Persius48/soap_dispenser_project/Soap Dispenser_Cross.JPG

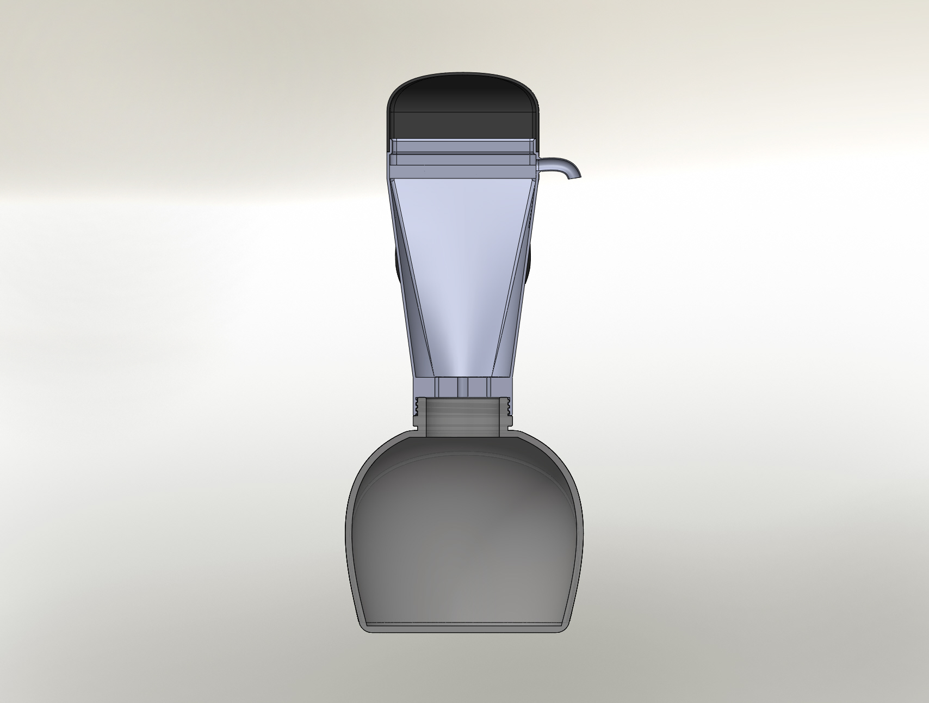
Soap Dispenser_Cross.JPG
