Persius48/soap_dispenser_project/Untitled.JPG

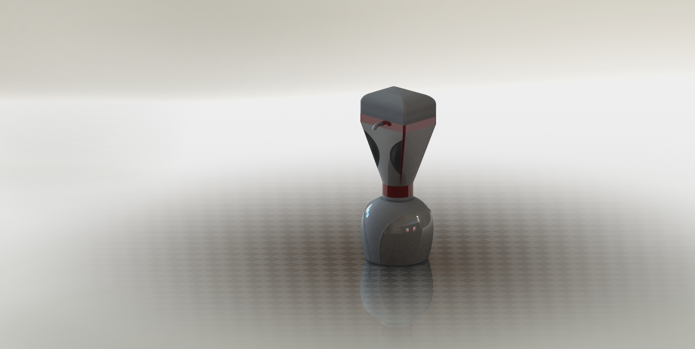
Untitled.JPG
