Persius48/soap_dispenser_project/Housing_Part.JPG

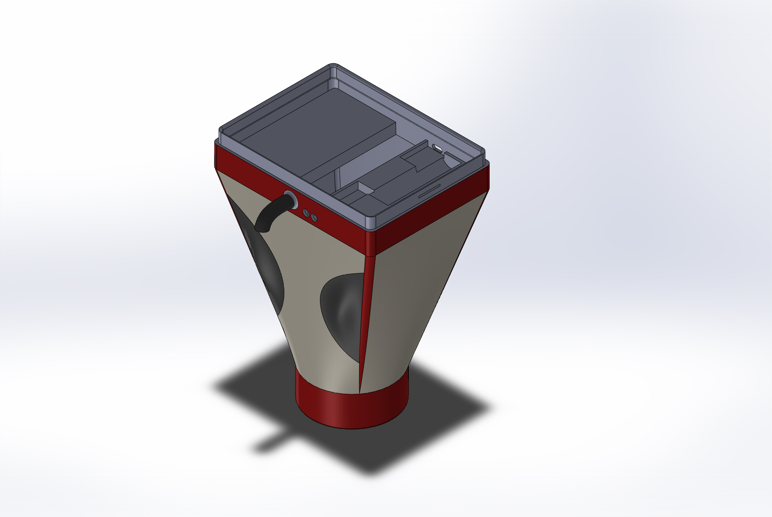
Housing_Part.JPG
