Persius48/soap_dispenser_project/Soap Tank.JPG

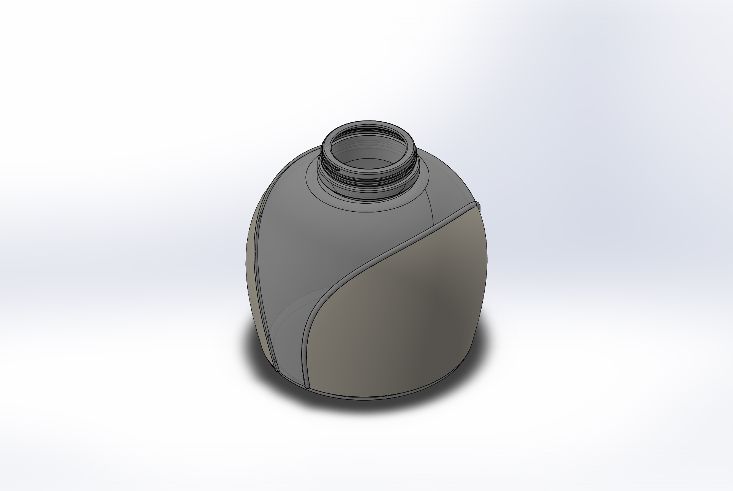
Soap Tank.JPG
