Persius48/soap_dispenser_project/Top Cap.JPG

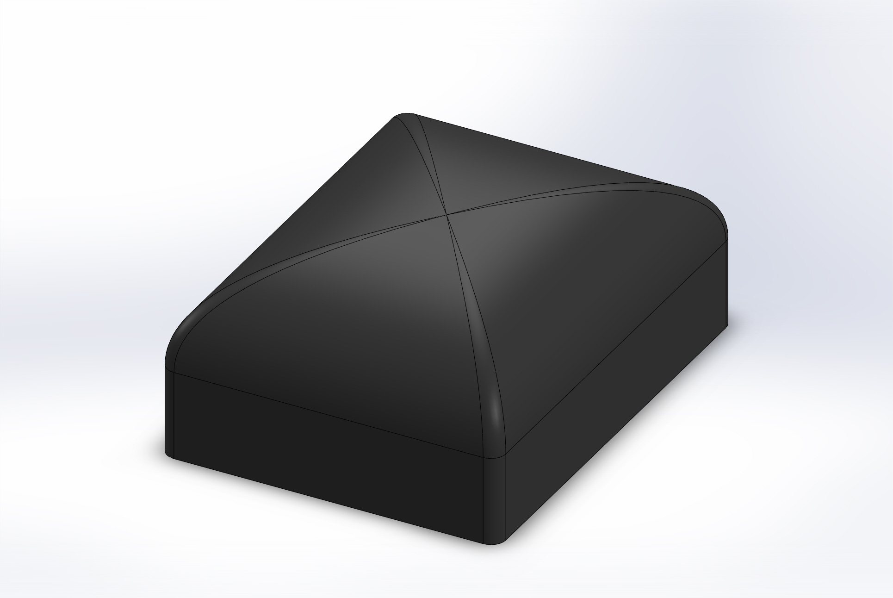
Top Cap.JPG
