Persius48/soap_dispenser_project/Soap Dispenser.SLDASM

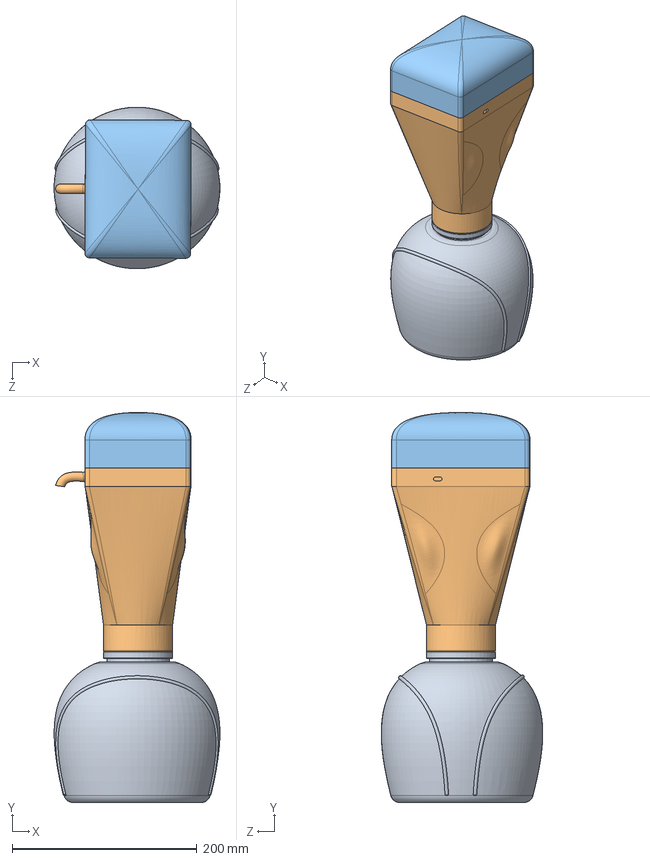
[picture p23: CAD file, 2023-07-30]
Soap Dispenser.SLDASM
179.7 x 422.6 x 175.0 mm
Soap Tank^Soap Dispenser
Housing
Top Cap^Soap Dispenser
