Persius48/soap_dispenser_project/Top Cap^Soap Dispenser.SLDPRT

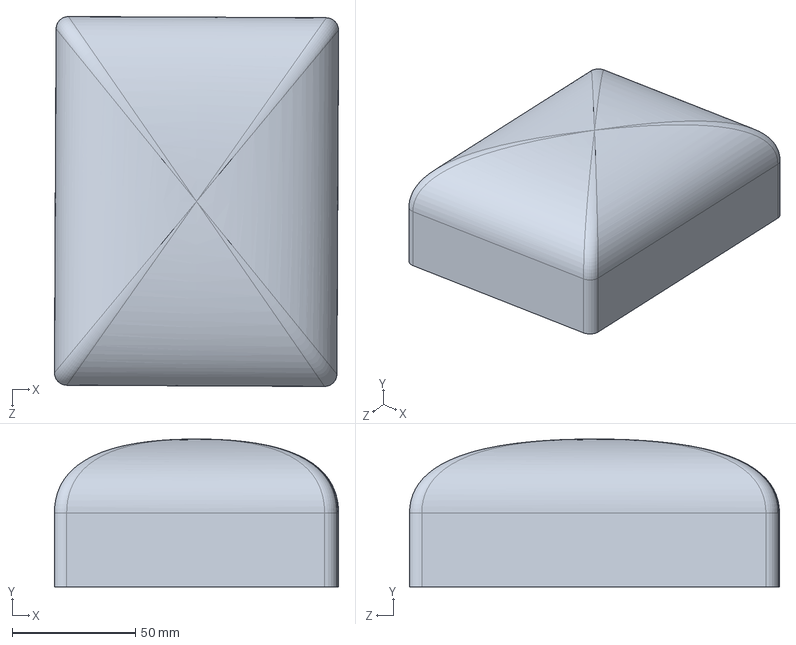
[picture p24: CAD file, 2023-07-30]
Top Cap^Soap Dispenser.SLDPRT
115.2 x 60.0 x 150.0 mm
