Persius48/soap_dispenser_project/Housing Add-inn.SLDPRT

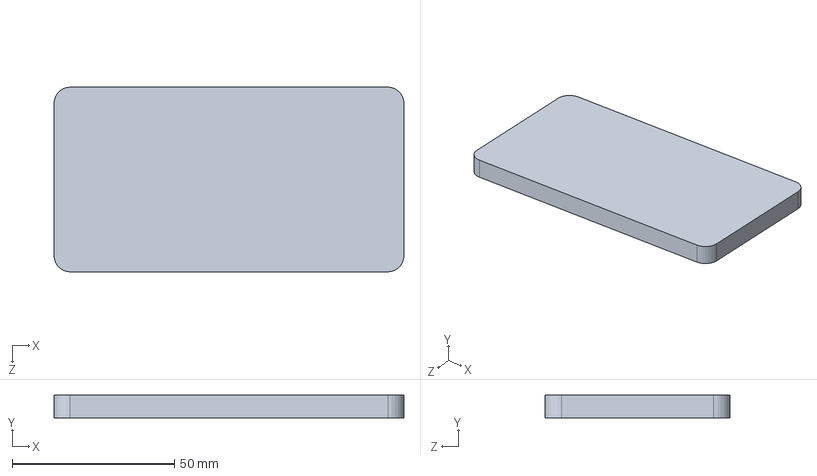
[picture p25: CAD file, 2023-07-30]
Housing Add-inn.SLDPRT
108.0 x 7.00 x 57.0 mm
