Persius48/soap_dispenser_project/Soap Tank^Soap Dispenser.SLDPRT

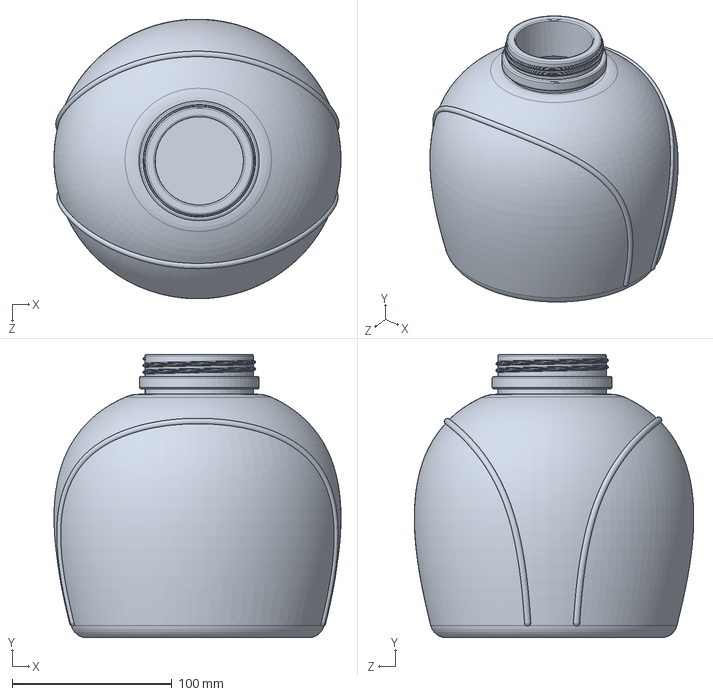
[picture p26: CAD file, 2023-07-30]
Soap Tank^Soap Dispenser.SLDPRT
179.7 x 177.4 x 175.0 mm
