Persius48/soap_dispenser_project/Housing.SLDPRT

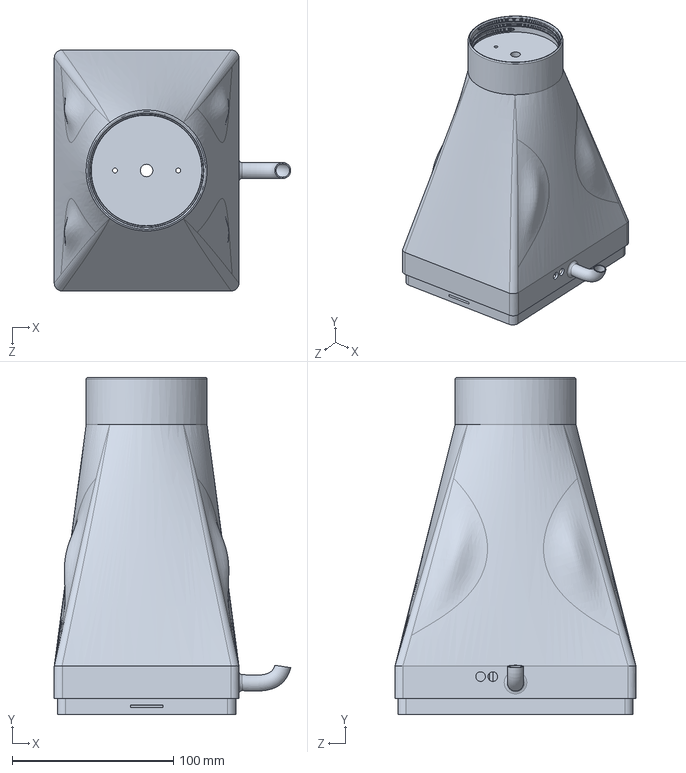
[picture p27: CAD file, 2023-07-30]
Housing.SLDPRT
146.7 x 209.0 x 149.5 mm
