Persius48/soap_dispenser_project/(list of files, cad)

Other CAD files:
Housing Add-inn.STL
Housing.SLDDRW
Housing.STL
Soap Dispenser.SLDDRW
Soap Tank^Soap Dispenser.SLDDRW
Soap Tank^Soap Dispenser.STL
Top Cap^Soap Dispenser.SLDDRW
Top Cap^Soap Dispenser.STL
makeProjectedPlanarWire.x_t
